Xilef12000/Laser-Parkour/PCBs/README.md

# Library sources:
## RPi Pico
from [github.com/ncarandini/KiCad-RP-Pico](https://github.com/ncarandini/KiCad-RP-Pico):
- `MCU_RaspberryPi_and_Boards.kicad_sym`
- `Pico.wrl`
- `RPi_Pico_SMD_TH.kicad_mod` 

## Würth Elektronik
converted from files provided by [Würth Elektronik](https://www.we-online.com/):
- `WR-DC DC Power Jack Right Angled (6.4).kicad_mod`
- `WR-MJ Modular Jack Horizontal Shielded w. EMI Panel Finger 8P8C Tab Up.kicad_mod`
- `WS-ENTV_4820XX514001.kicad_mod`
