Xilef12000/Laser-Parkour/PCBs/Controller/Controller.kicad_pcb

## KiCad design PCBs/Controller/Controller.kicad_pcb (2025-03-29)

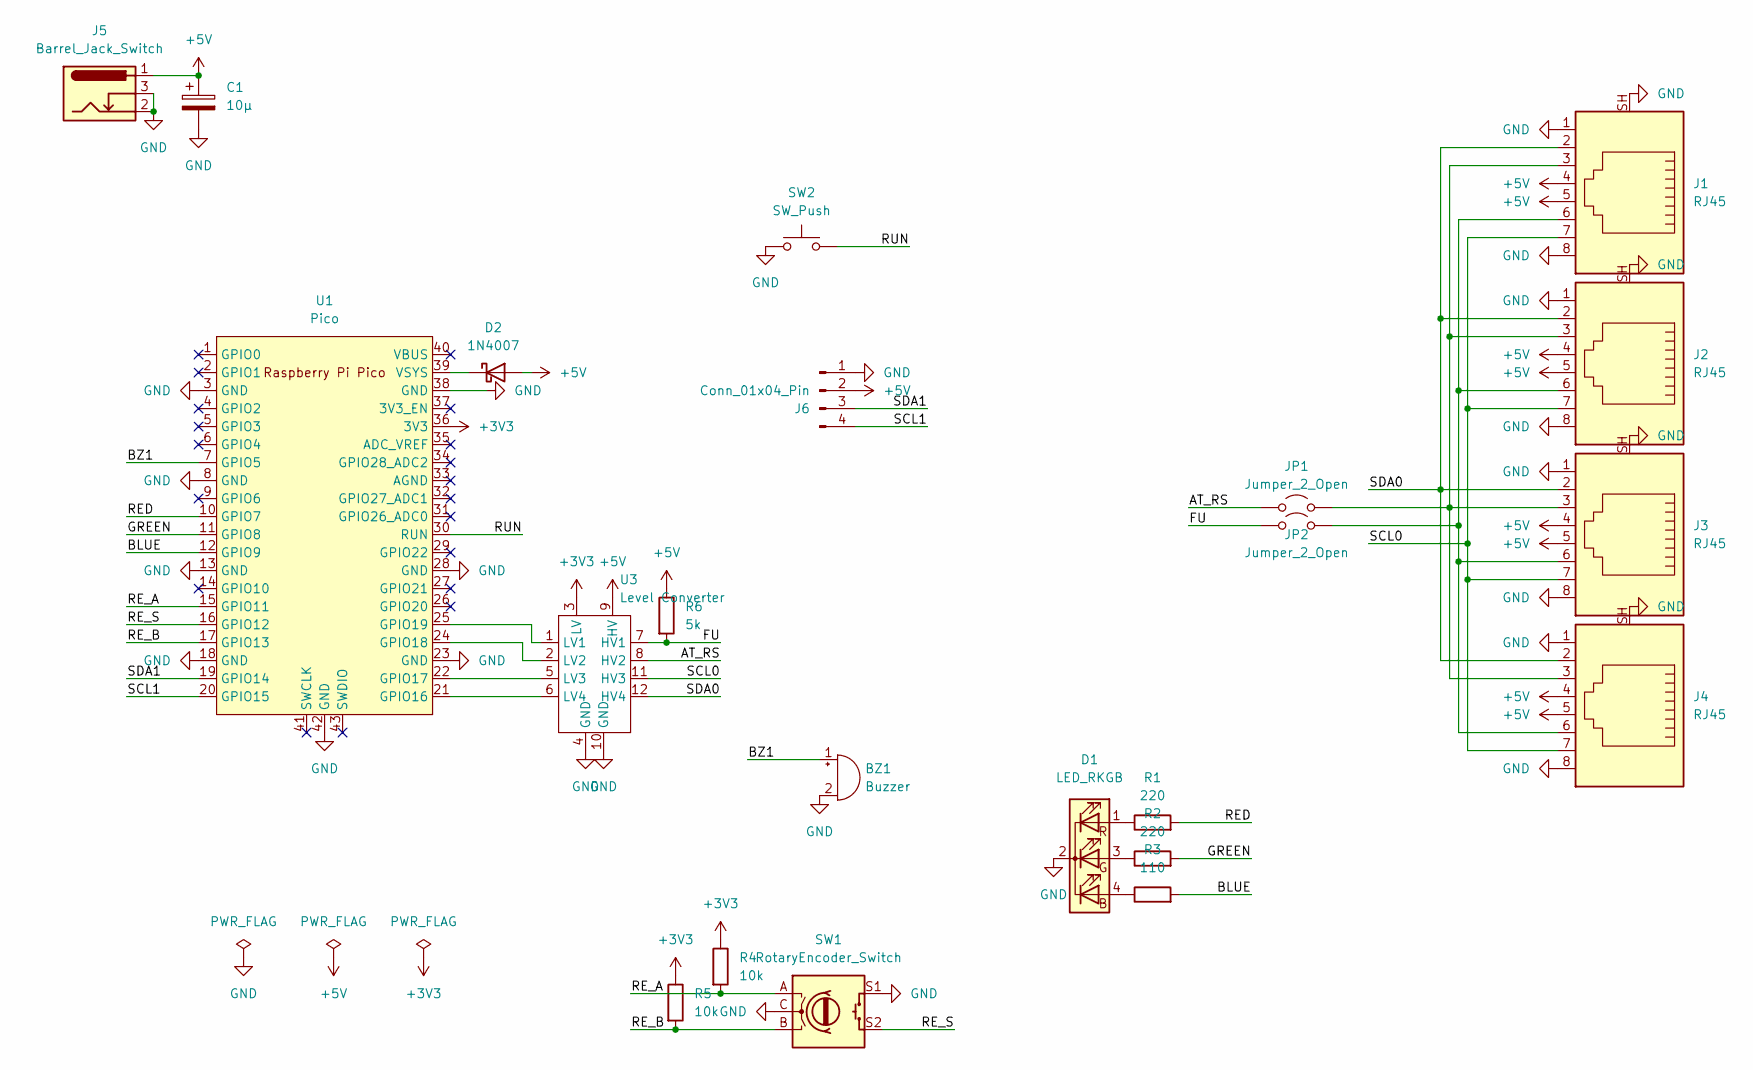
[picture p1: schematic Controller.kicad_sch, Laser-Parkour Controller]

Parts:
BZ1: Buzzer; Buzzer_12x9.5RM7.6
C1: 10μ; CP_Radial_D5.0mm_P2.00mm
D1: LED_RKGB; LED_D5.0mm-4_RGB_Wide_Pins
D2: 1N4007; D_DO-41_SOD81_P7.62mm_Horizontal
J1, J2, J3, J4: RJ45; WR-MJ Modular Jack Horizontal Shielded w. EMI Panel Finger 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
J5: Barrel_Jack_Switch; WR-DC DC Power Jack Right Angled (6.4)
J6: Conn_01x04_Pin; PinHeader_1x04_P2.54mm_Vertical
JP1, JP2: Jumper_2_Open; SolderJumper-2_P1.3mm_Open_RoundedPad1.0x1.5mm
R1, R2: 220; R_Axial_DIN0207_L6.3mm_D2.5mm_P10.16mm_Horizontal
R3: 110; R_Axial_DIN0207_L6.3mm_D2.5mm_P10.16mm_Horizontal
R4, R5: 10k; R_Axial_DIN0207_L6.3mm_D2.5mm_P10.16mm_Horizontal
R6: 5k; R_Axial_DIN0207_L6.3mm_D2.5mm_P10.16mm_Horizontal
SW1: RotaryEncoder_Switch; WS-ENTV_4820XX514001
SW2: SW_Push; SW_PUSH_6mm_H4.3mm
U1: Pico; RPi_Pico_SMD_TH
U3: Level Converter; Level_Converter

Connections:
+3V3: R4.1, R5.1, U1.36 (3V3), U3.3 (LV)
+5V: C1.1, D2.2 (A), J1.4, J1.5, J2.4, J2.5, J3.4, J3.5, J4.4, J4.5, J5.1, J6.2, R6.1, U3.9 (HV)
/AT_RS: JP1.1 (A), U3.8 (HV2)
/BLUE: R3.2, U1.12 (GPIO9)
/BZ1: BZ1.1 (+), U1.7 (GPIO5)
/FU: JP2.1 (A), R6.2, U3.7 (HV1)
/GREEN: R2.2, U1.11 (GPIO8)
/RED: R1.2, U1.10 (GPIO7)
/RE_A: R4.2, SW1.A, U1.15 (GPIO11)
/RE_B: R5.2, SW1.B, U1.17 (GPIO13)
/RE_S: SW1.S2, U1.16 (GPIO12)
/RUN: SW2.2, U1.30 (RUN)
/SCL0: J1.7, J2.7, J3.7, J4.7, U3.11 (HV3)
/SCL1: J6.4, U1.20 (GPIO15)
/SDA0: J1.2, J2.2, J3.2, J4.2, U3.12 (HV4)
/SDA1: J6.3, U1.19 (GPIO14)
GND: BZ1.2 (-), C1.2, D1.2 (K), J1.1, J1.8, J1.SH, J2.1, J2.8, J2.SH, J3.1, J3.8, J3.SH, J4.1, J4.8, J4.SH, J5.2, J5.3, J6.1, SW1.C, SW1.S1, SW2.1, U1.3 (GND), U1.8 (GND), U1.13 (GND), U1.18 (GND), U1.23 (GND), U1.28 (GND), U1.38 (GND), U1.42 (GND), U3.4 (GND), U3.10 (GND)
unnamed: D1.4 (BA), R3.1
unnamed: D1.3 (GA), R2.1
unnamed: D1.1 (RA), R1.1
unnamed: D2.1 (K), U1.39 (VSYS)
unnamed: J1.3, J2.3, J3.3, J4.3, JP1.2 (B)
unnamed: J1.6, J2.6, J3.6, J4.6, JP2.2 (B)
unnamed: U1.21 (GPIO16), U3.6 (LV4)
unnamed: U1.22 (GPIO17), U3.5 (LV3)
unnamed: U1.24 (GPIO18), U3.2 (LV2)
unnamed: U1.25 (GPIO19), U3.1 (LV1)

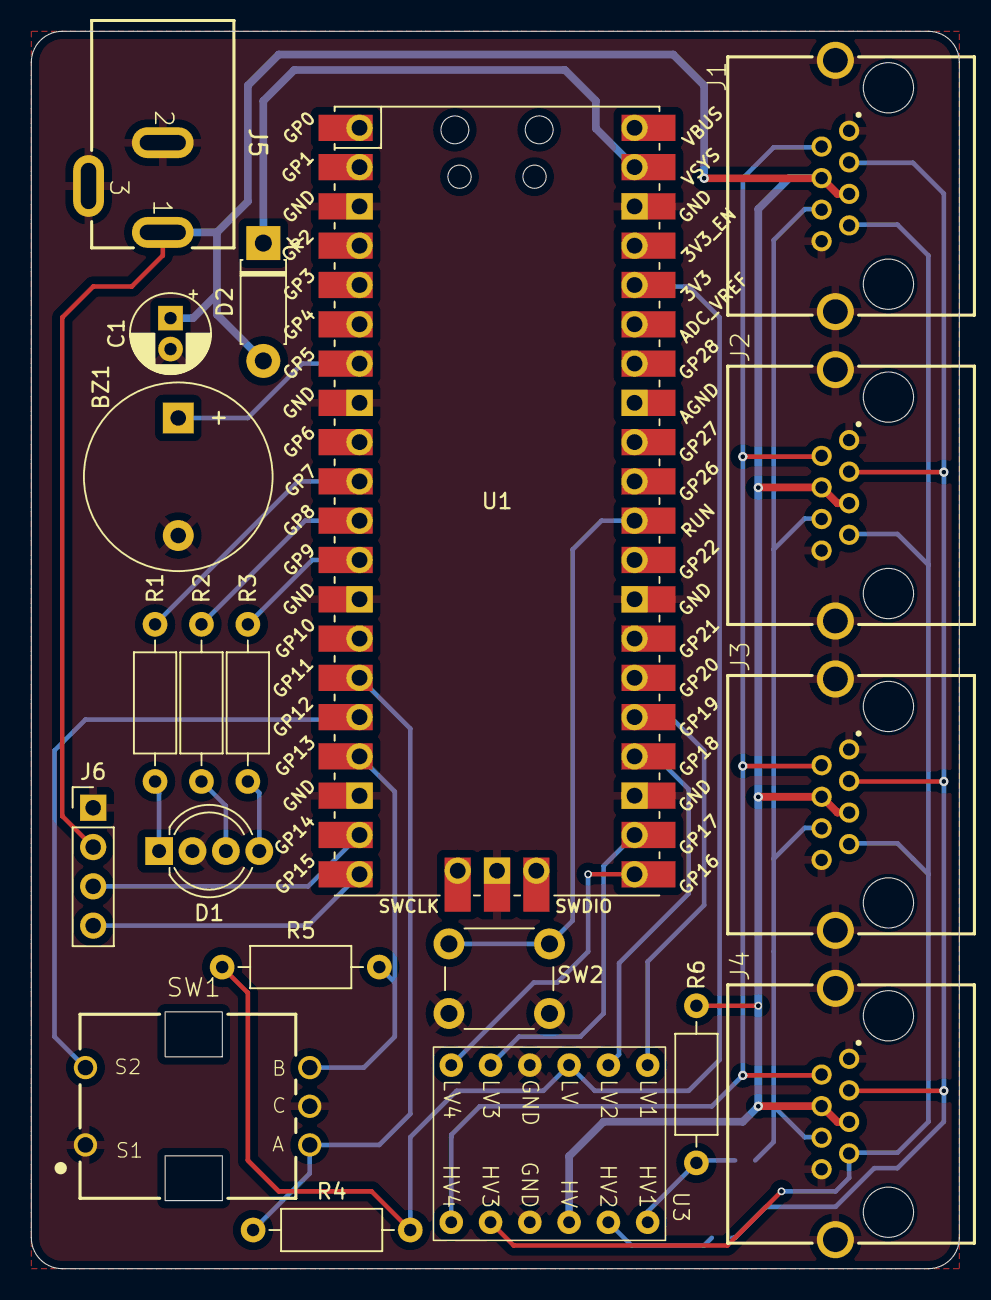
[picture p2: board Controller.kicad_pcb from above]

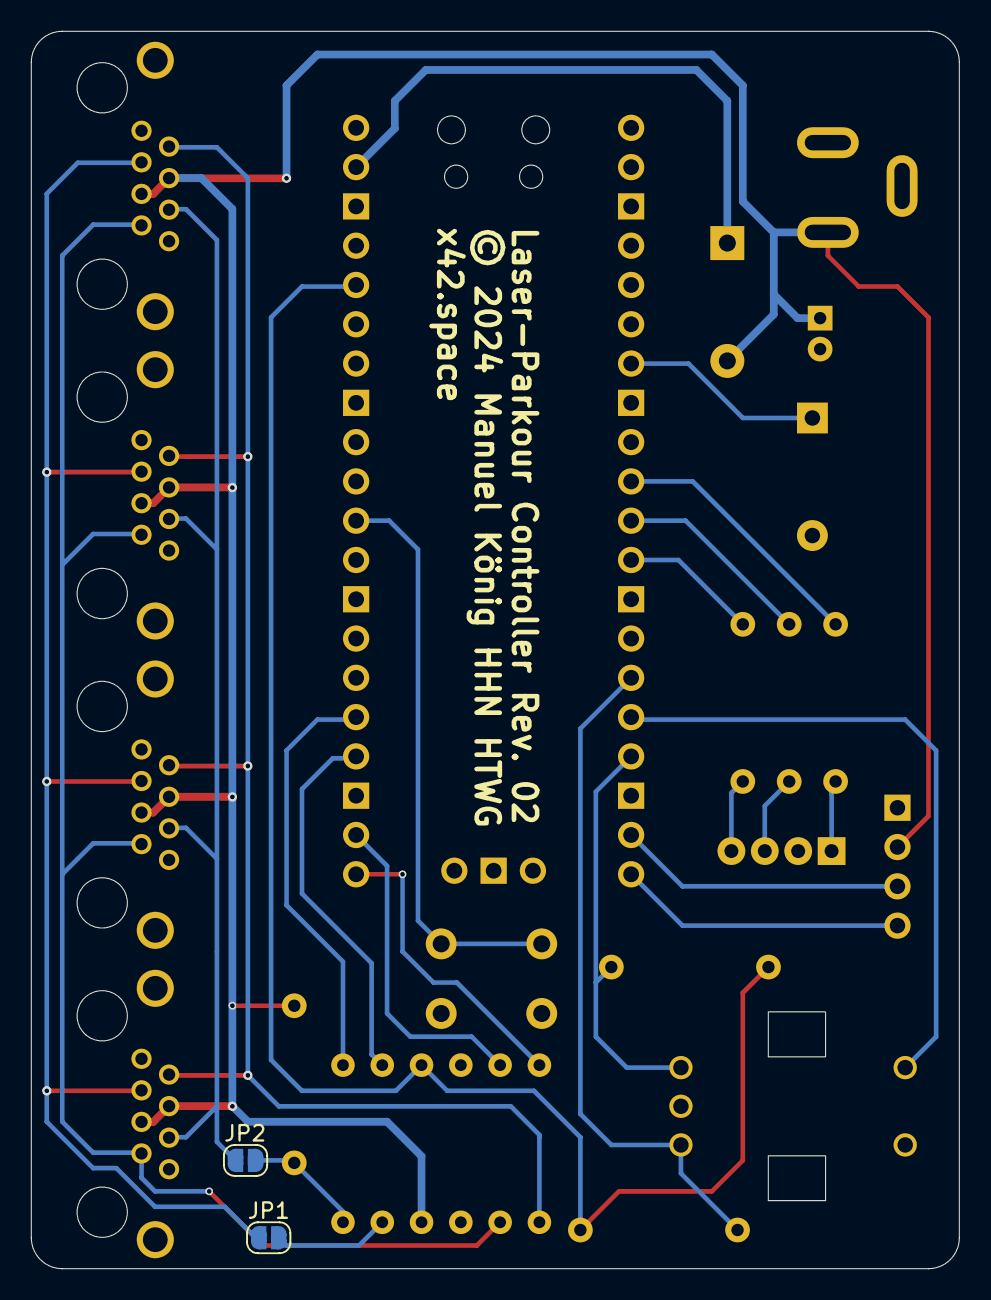
[picture p3: board Controller.kicad_pcb from below]

Board: 2 copper layers, 60.0 x 80.0 mm, 22 parts (2 on the bottom side), 27 nets.
