Xilef12000/Laser-Parkour/PCBs/Sensor/Sensor.kicad_pcb

## KiCad design PCBs/Sensor/Sensor.kicad_pcb (2025-02-28)

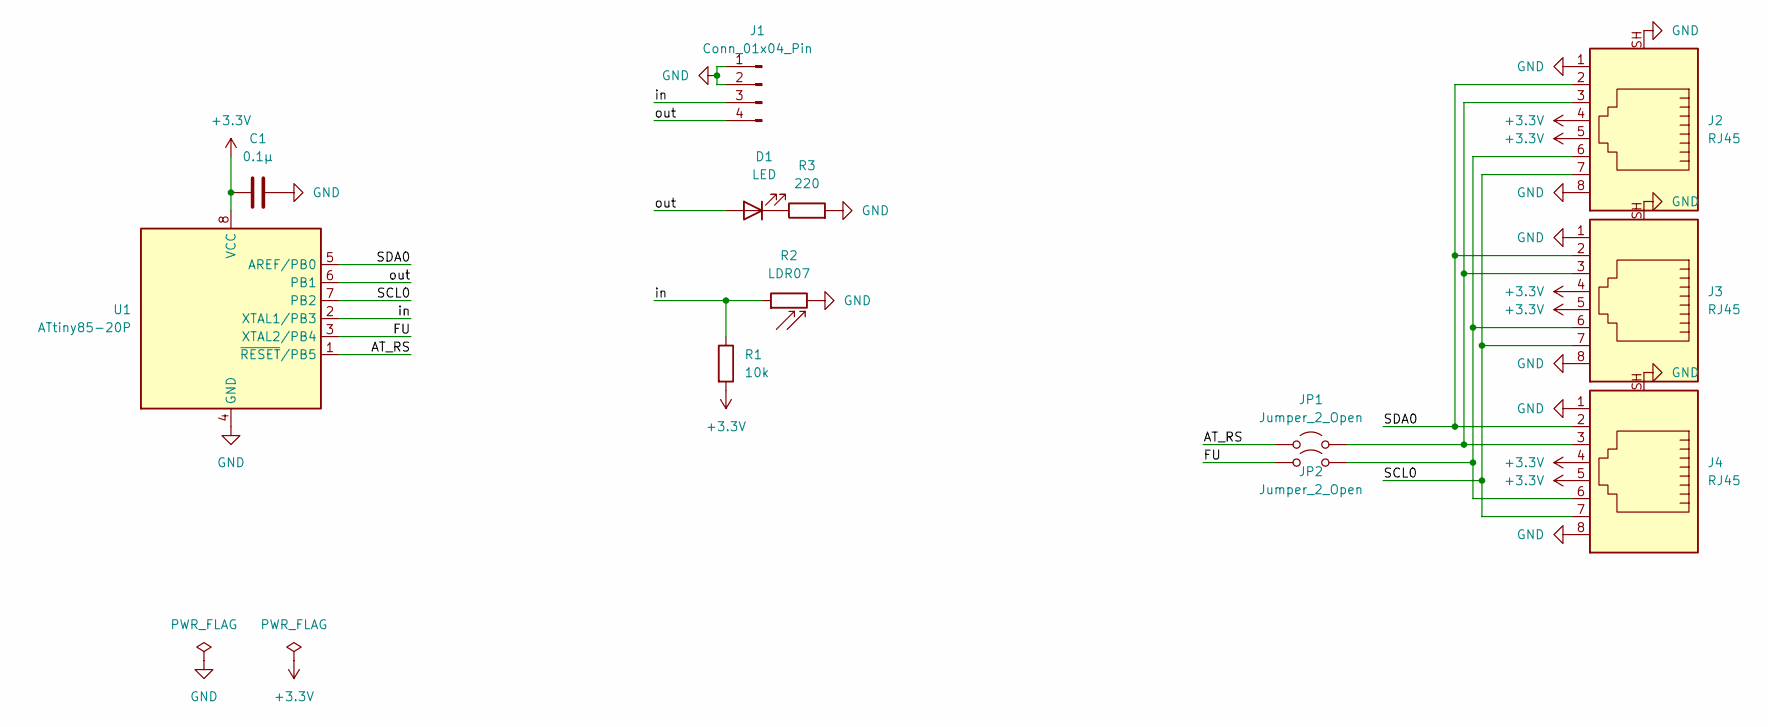
[picture p4: schematic Sensor.kicad_sch, Laser-Parkour Sensor]

Parts:
C1: 0.1μ; C_Disc_D3.0mm_W1.6mm_P2.50mm
D1: LED; LED_D5.0mm
J1: Conn_01x04_Pin; PinHeader_1x04_P2.54mm_Vertical
J2, J3, J4: RJ45; WR-MJ Modular Jack Horizontal Shielded w. EMI Panel Finger 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
JP1, JP2: Jumper_2_Open; SolderJumper-2_P1.3mm_Open_RoundedPad1.0x1.5mm
R1: 10k; R_Axial_DIN0207_L6.3mm_D2.5mm_P10.16mm_Horizontal
R2: LDR07; R_LDR_5.1x4.3mm_P3.4mm_Vertical
R3: 220; R_Axial_DIN0207_L6.3mm_D2.5mm_P10.16mm_Horizontal
U1: ATtiny85-20P; DIP-8_W7.62mm

Connections:
+3.3V: C1.1, J2.4, J2.5, J3.4, J3.5, J4.4, J4.5, R1.2, U1.8 (VCC)
/AT_RS: JP1.1 (A), U1.1 (~RESET/PB5)
/FU: JP2.1 (A), U1.3 (XTAL2/PB4)
/SCL0: J2.7, J3.7, J4.7, U1.7 (PB2)
/SDA0: J2.2, J3.2, J4.2, U1.5 (AREF/PB0)
/in: J1.3, R1.1, R2.1, U1.2 (XTAL1/PB3)
/out: D1.2 (A), J1.4, U1.6 (PB1)
GND: C1.2, J1.1, J1.2, J2.1, J2.8, J2.SH, J3.1, J3.8, J3.SH, J4.1, J4.8, J4.SH, R2.2, R3.2, U1.4 (GND)
unnamed: D1.1 (K), R3.1
unnamed: J2.3, J3.3, J4.3, JP1.2 (B)
unnamed: J2.6, J3.6, J4.6, JP2.2 (B)

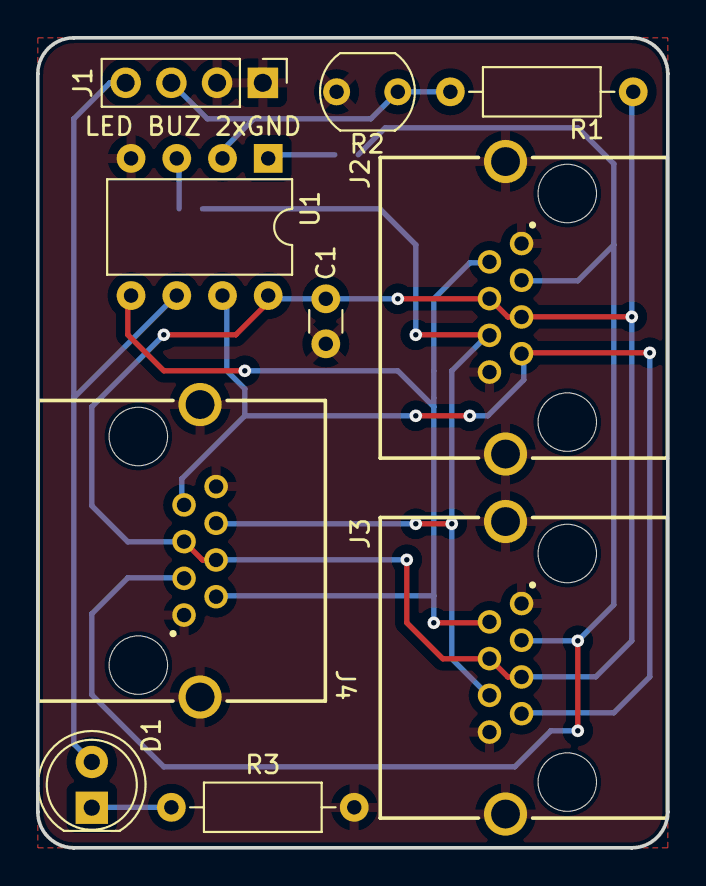
[picture p5: board Sensor.kicad_pcb from above]

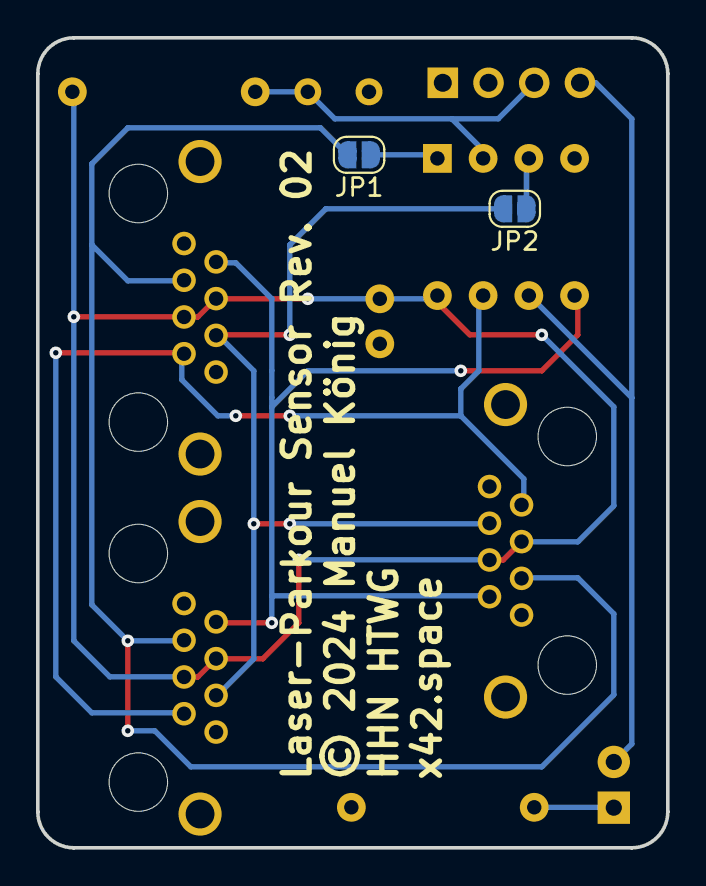
[picture p6: board Sensor.kicad_pcb from below]

Board: 2 copper layers, 35.0 x 45.0 mm, 12 parts (2 on the bottom side), 11 nets.
