Xilef12000/Laser-Parkour/(commit log)

2024-08-18 simple I2C communication
2024-08-18 Sensor PCB schematic
    [Sensor.kicad_pcb, Sensor.kicad_sch]
2024-08-24 assigned footprints
    [Sensor.kicad_sch]
2024-08-24 added info text
    [Sensor.kicad_pcb, Sensor.kicad_sch]
2024-08-24 update footprint
    [Buzzer.kicad_pcb, Buzzer.kicad_sch, Sensor.kicad_pcb, Sensor.kicad_sch]
2024-08-24 added nc
    [Buzzer.kicad_sch, Sensor.kicad_sch]
2024-08-25 pcb page setup
    [Controller.kicad_pcb]
2024-09-01 update RJ45 pins and pwr_flag
    [Controller.kicad_sch, Sensor.kicad_pcb, Sensor.kicad_sch]
2024-09-01 integrate buzzer PCB into Sensor
    [Buzzer.kicad_pcb, Buzzer.kicad_sch, Sensor.kicad_pcb, Sensor.kicad_sch]
2024-09-06 added jumper pad
    [Sensor.kicad_pcb, Sensor.kicad_sch]
2024-09-07 update sensor
    [Controller.kicad_pcb, Controller.kicad_sch]
2024-09-07 added text
    [Controller.kicad_pcb]
2024-09-08 added Capacitors
    [Controller.kicad_pcb, Controller.kicad_sch]
2024-09-08 rounded corners
    [Controller.kicad_pcb]
2024-09-08 better rj45 routing
    [Controller.kicad_pcb]
2024-09-23 pi pico w controller
2024-10-06 imported Aisler Board Rules
    https://github.com/AislerHQ/aisler-support
    [Sensor.kicad_pcb]
2024-10-06 fixed pcb
    [Sensor.kicad_pcb]
2024-10-19 wider traces
    [Sensor.kicad_pcb]
2024-11-10 sensor rescan button
2025-02-22 Controller Rev. 01
    [Controller.kicad_pcb, Controller.kicad_sch]
2025-02-24 commit to safe current state
2025-02-28 update pcb
    [Controller.kicad_pcb, Sensor.kicad_pcb]
2025-03-04 handle sensor reconnect
2025-03-05 laser interrupt penalty
2025-03-29 Controller Rev. 02
    [Controller.kicad_pcb, Controller.kicad_sch]
2025-04-06 lost sensor while running game
2025-04-06 debug leds
2025-04-06 cancel game/setup button
