Xilef12000/Laser-Parkour/(notices)

Notices in the files:
PCBs/Controller/Controller.kicad_pcb:
© 2024 Manuel König HHN HTWG
